LuisMiguelCarmonaCortes/IMPASS/Documentacion/Diagrama_IMPASS.png

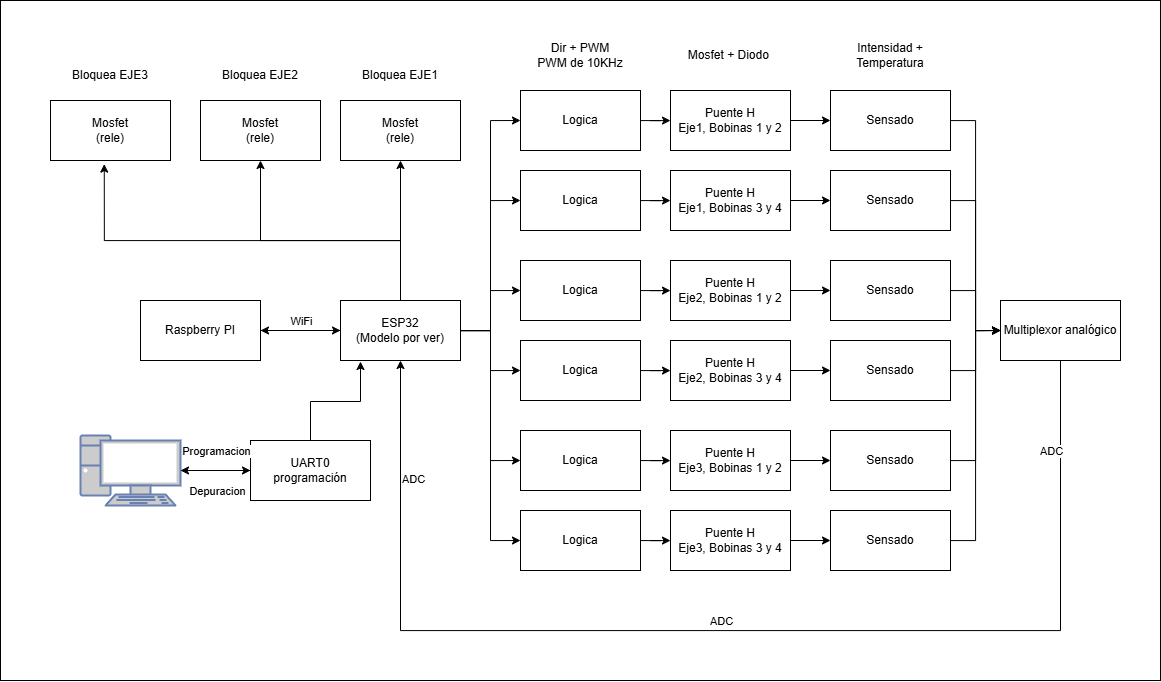
Documentacion/Diagrama_IMPASS.png
