LuisMiguelCarmonaCortes/IMPASS/Documentacion/Carro_ene.08_0310.xls

CESTA DE LA COMPRA
Esto no es una factura
08-ene.-26 15:10:57
 | Mouser REF | Fabr. N.º | Fabricante | Ref. Cliente | Descripción | RoHS | Ciclo de vida | Ctd. pedido | Precio (EUR) | Precio total: (EUR)
1 | 637-2N7002 | 2N7002 | Diotec Semiconductor |  | MOSFET MOSFET, SOT-23, 60V, 0.28A, 150C, N | Cumple RoHS |  | 50 | 0,077 € | 3,85 €
2 | 621-DMN3008SFG-7 | DMN3008SFG-7 | Diodes Incorporated |  | MOSFET 30V N-Ch Enh FET 4.6mOhm 10Vgs 17.6A | Cumple RoHS |  | 60 | 0,531 € | 31,86 €
3 | 581-06036C104KAT2A | 06036C104KAT2A | KYOCERA AVX |  | Condensadores de cerámica multicapa (MLCC- SMD/SMT) KGM15AR70J104KT NEW GLOBAL PN 6.3V 0.1uF A 581-KGM15AR70J104KT | Cumple RoHS |  | 20 | 0,025 € | 0,50 €
4 | 187-CL21A106KOQNNNG | CL21A106KOQNNNG | Samsung Electro-Mechanics |  | Condensadores de cerámica multicapa (MLCC- SMD/SMT) 10uF+/-10% 16V X5R 2 0805 | Cumple RoHS |  | 10 | 0,009 € | 0,09 €
5 | 581-KGM15AR71H102MT | KGM15AR71H102MT | KYOCERA AVX |  | Condensadores de cerámica multicapa (MLCC- SMD/SMT) 50V .001uF X7R 0603 20% | Cumple RoHS |  | 20 | 0,023 € | 0,46 €
6 | 708-RNCS0603BKE10K0 | RNCS0603BKE10K0 | SEI Stackpole |  | Resistores de pel&iacute;cula fina - SMD 10KOhms 0603 0.063W 25ppm 0.1% Moist Resist AEC-Q200 | Cumple RoHS |  | 60 | 0,082 € | 4,92 €
7 | 78-1N4448 | 1N4448TR | Vishay |  | Diodos de conmutación de señal pequeña Vr/75V Io/150mA T/R | Conforme con RoHS por exención |  | 15 | 0,027 € | 0,41 €
8 | 771-LM75BD118 | LM75BD,118 | NXP |  | Sensores de temperatura montados en placa I2C LOCAL +/- 20C TS DIGITAL TEMP SENSOR | Cumple RoHS |  | 5 | 0,442 € | 2,21 €
9 | 250-71240LLCBTR045B5 | ACS71240LLCBTR-045B5 | Allegro MicroSystems |  | Sensores de corriente montados en placa CURRENT SENSOR IC WITH COMMON MODE REJECTION | Conforme con RoHS por exención |  | 15 | 1,51 € | 22,65 €
10 | 356-ESP32S3WRM1N16R2 | ESP32-S3-WROOM-1-N16R2 | Espressif |  | Módulos multiprotocolo SMD module, ESP32-S3R2 with 2 MB PSRAM die inside, 16 MB SPI flash, PCB antenna | Cumple RoHS |  | 2 | 5,36 € | 10,72 €
11 | 179-TB0011-350-02GR | TB0011-350-02GR | Same Sky |  | Bloques terminales fijos 2 Poles, Screw Type, Horizontal, 3.50 Pitch, 24-18 (AWG), Green, Terminal Block Connector | Cumple RoHS | Nuevo producto | 20 | 0,347 € | 6,94 €
Al enviar su pedido, usted acepta estos términos y condiciones. (https://www.mouser.es/saleterms) |  |  |  |  |  |  |  |  | Mercancía: | 84,61 €
Los precios se reflejan en la fecha y hora mostradas. |  |  |  |  |  |  |  |  | Gastos de envío: | 0,00 €
