LuisMiguelCarmonaCortes/IMPASS/Hardware/PCB/IMPASS/IMPASS.kicad_pcb

## KiCad design Hardware/PCB/IMPASS/IMPASS.kicad_pcb (2026-03-23)

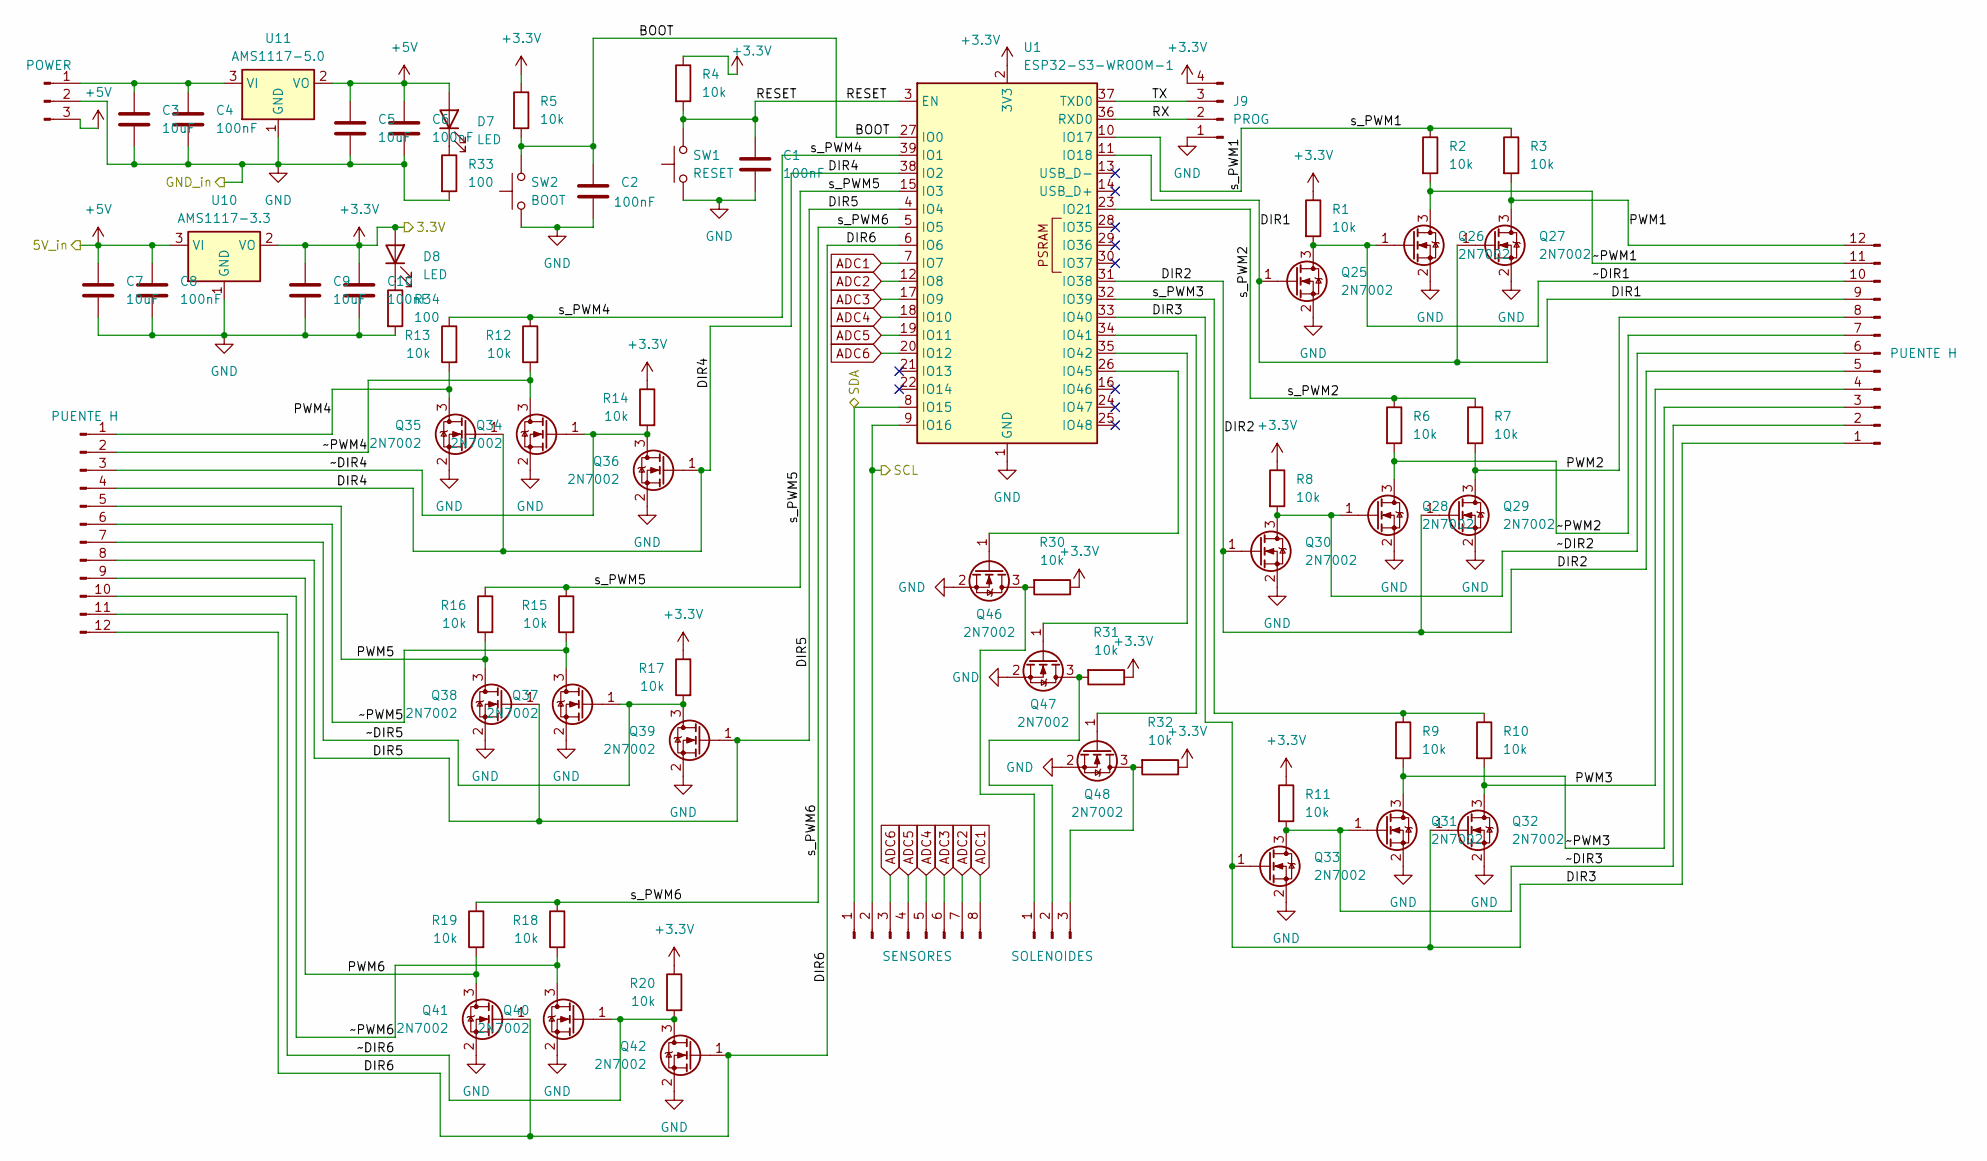
[picture p60: schematic Logica.kicad_sch]

Parts:
C1, C2, C4, C6, C8, C10: 100nF; C_0603_1608Metric
C3, C5, C7, C9: 10uF; C_0805_2012Metric
D7, D8: LED; LED_0603_1608Metric
J1, J7: PUENTE H; PinHeader_1x12_P2.54mm_Vertical
J8: SOLENOIDES; PinHeader_1x03_P2.54mm_Vertical
J9: PROG; PinHeader_1x04_P2.54mm_Horizontal
J10: SENSORES; PinHeader_1x08_P2.54mm_Vertical
J12: POWER; PinHeader_1x03_P2.54mm_Vertical
Q25, Q26, Q27, Q28, Q29, Q30, Q31, Q32, Q33, Q34, Q35, Q36, Q37, Q38, Q39, Q40, Q41, Q42, Q46, Q47, Q48: 2N7002; SOT-23
R1, R2, R3, R4, R5, R6, R7, R8, R9, R10, R11, R12, R13, R14, R15, R16, R17, R18, R19, R20, R30, R31, R32: 10k; R_0603_1608Metric
R33, R34: 100; R_0603_1608Metric
SW1: RESET; SW_PUSH_6mm_H5mm
SW2: BOOT; SW_PUSH_6mm_H5mm
U1: ESP32-S3-WROOM-1
U10: AMS1117-3.3; SOT-223-3_TabPin2
U11: AMS1117-5.0; SOT-223-3_TabPin2

Connections:
+3.3V: C9.1, C10.1, D8.2 (A), J9.4, R1.1, R4.1, R5.1, R8.1, R11.1, R14.1, R17.1, R20.1, R30.1, R31.1, R32.1, U1.2 (3V3), U10.2 (VO); also elsewhere on the board
+5V: C5.1, C6.1, C7.1, C8.1, D7.2 (A), J12.3, U10.3 (VI), U11.2 (VO)
/Logica/BOOT: C2.1, R5.2, SW2.2, U1.27 (IO0)
/Logica/DIR1: J7.9, Q25.1 (G), Q27.1 (G), U1.11 (IO18)
/Logica/DIR2: J7.5, Q29.1 (G), Q30.1 (G), U1.31 (IO38)
/Logica/DIR3: J7.1, Q32.1 (G), Q33.1 (G), U1.33 (IO40)
/Logica/DIR4: J1.4, Q35.1 (G), Q36.1 (G), U1.38 (IO2)
/Logica/DIR5: J1.8, Q38.1 (G), Q39.1 (G), U1.4 (IO4)
/Logica/DIR6: J1.12, Q41.1 (G), Q42.1 (G), U1.6 (IO6)
/Logica/PWM1: J7.12, Q27.3 (D), R3.2
/Logica/PWM2: J7.8, Q29.3 (D), R7.2
/Logica/PWM3: J7.4, Q32.3 (D), R10.2
/Logica/PWM4: J1.1, Q35.3 (D), R13.2
/Logica/PWM5: J1.5, Q38.3 (D), R16.2
/Logica/PWM6: J1.9, Q41.3 (D), R19.2
/Logica/RESET: C1.1, R4.2, SW1.2, U1.3 (EN)
/Logica/RX: J9.2, U1.36 (RXD0)
/Logica/SCL: J10.2, U1.9 (IO16); also elsewhere on the board
/Logica/SDA: J10.1, U1.8 (IO15); also elsewhere on the board
/Logica/TX: J9.3, U1.37 (TXD0)
/Logica/s_PWM1: R2.1, R3.1, U1.10 (IO17)
/Logica/s_PWM2: R6.1, R7.1, U1.23 (IO21)
/Logica/s_PWM3: R9.1, R10.1, U1.32 (IO39)
/Logica/s_PWM4: R12.1, R13.1, U1.39 (IO1)
/Logica/s_PWM5: R15.1, R16.1, U1.15 (IO3)
/Logica/s_PWM6: R18.1, R19.1, U1.5 (IO5)
/Logica/~DIR1: J7.10, Q25.3 (D), Q26.1 (G), R1.2
/Logica/~DIR2: J7.6, Q28.1 (G), Q30.3 (D), R8.2
/Logica/~DIR3: J7.2, Q31.1 (G), Q33.3 (D), R11.2
/Logica/~DIR4: J1.3, Q34.1 (G), Q36.3 (D), R14.2
/Logica/~DIR5: J1.7, Q37.1 (G), Q39.3 (D), R17.2
/Logica/~DIR6: J1.11, Q40.1 (G), Q42.3 (D), R20.2
/Logica/~PWM1: J7.11, Q26.3 (D), R2.2
/Logica/~PWM2: J7.7, Q28.3 (D), R6.2
/Logica/~PWM3: J7.3, Q31.3 (D), R9.2
/Logica/~PWM4: J1.2, Q34.3 (D), R12.2
/Logica/~PWM5: J1.6, Q37.3 (D), R15.2
/Logica/~PWM6: J1.10, Q40.3 (D), R18.2
ADC1: J10.8, U1.7 (IO7)
ADC2: J10.7, U1.12 (IO8)
ADC3: J10.6, U1.17 (IO9)
ADC4: J10.5, U1.18 (IO10)
ADC5: J10.4, U1.19 (IO11)
ADC6: J10.3, U1.20 (IO12)
GND: C1.2, C2.2, C3.2, C4.2, C5.2, C6.2, C7.2, C8.2, C9.2, C10.2, J9.1, J12.2, Q25.2 (S), Q26.2 (S), Q27.2 (S), Q28.2 (S), Q29.2 (S), Q30.2 (S), Q31.2 (S), Q32.2 (S), Q33.2 (S), Q34.2 (S), Q35.2 (S), Q36.2 (S), Q37.2 (S), Q38.2 (S), Q39.2 (S), Q40.2 (S), Q41.2 (S), Q42.2 (S), Q46.2 (S), Q47.2 (S), Q48.2 (S), R33.2, R34.2, SW1.1, SW2.1, U1.1 (GND), U1.40 (GND), U1.41 (GND), U10.1 (GND), U11.1 (GND); also elsewhere on the board
unnamed: D7.1 (K), R33.1
unnamed: D8.1 (K), R34.1
unnamed: J8.1, Q46.3 (D), R30.2
unnamed: J8.2, Q47.3 (D), R31.2
unnamed: J8.3, Q48.3 (D), R32.2
unnamed: C3.1, C4.1, J12.1, U11.3 (VI)
unnamed: Q46.1 (G), U1.26 (IO45)
unnamed: Q47.1 (G), U1.35 (IO42)
unnamed: Q48.1 (G), U1.34 (IO41)

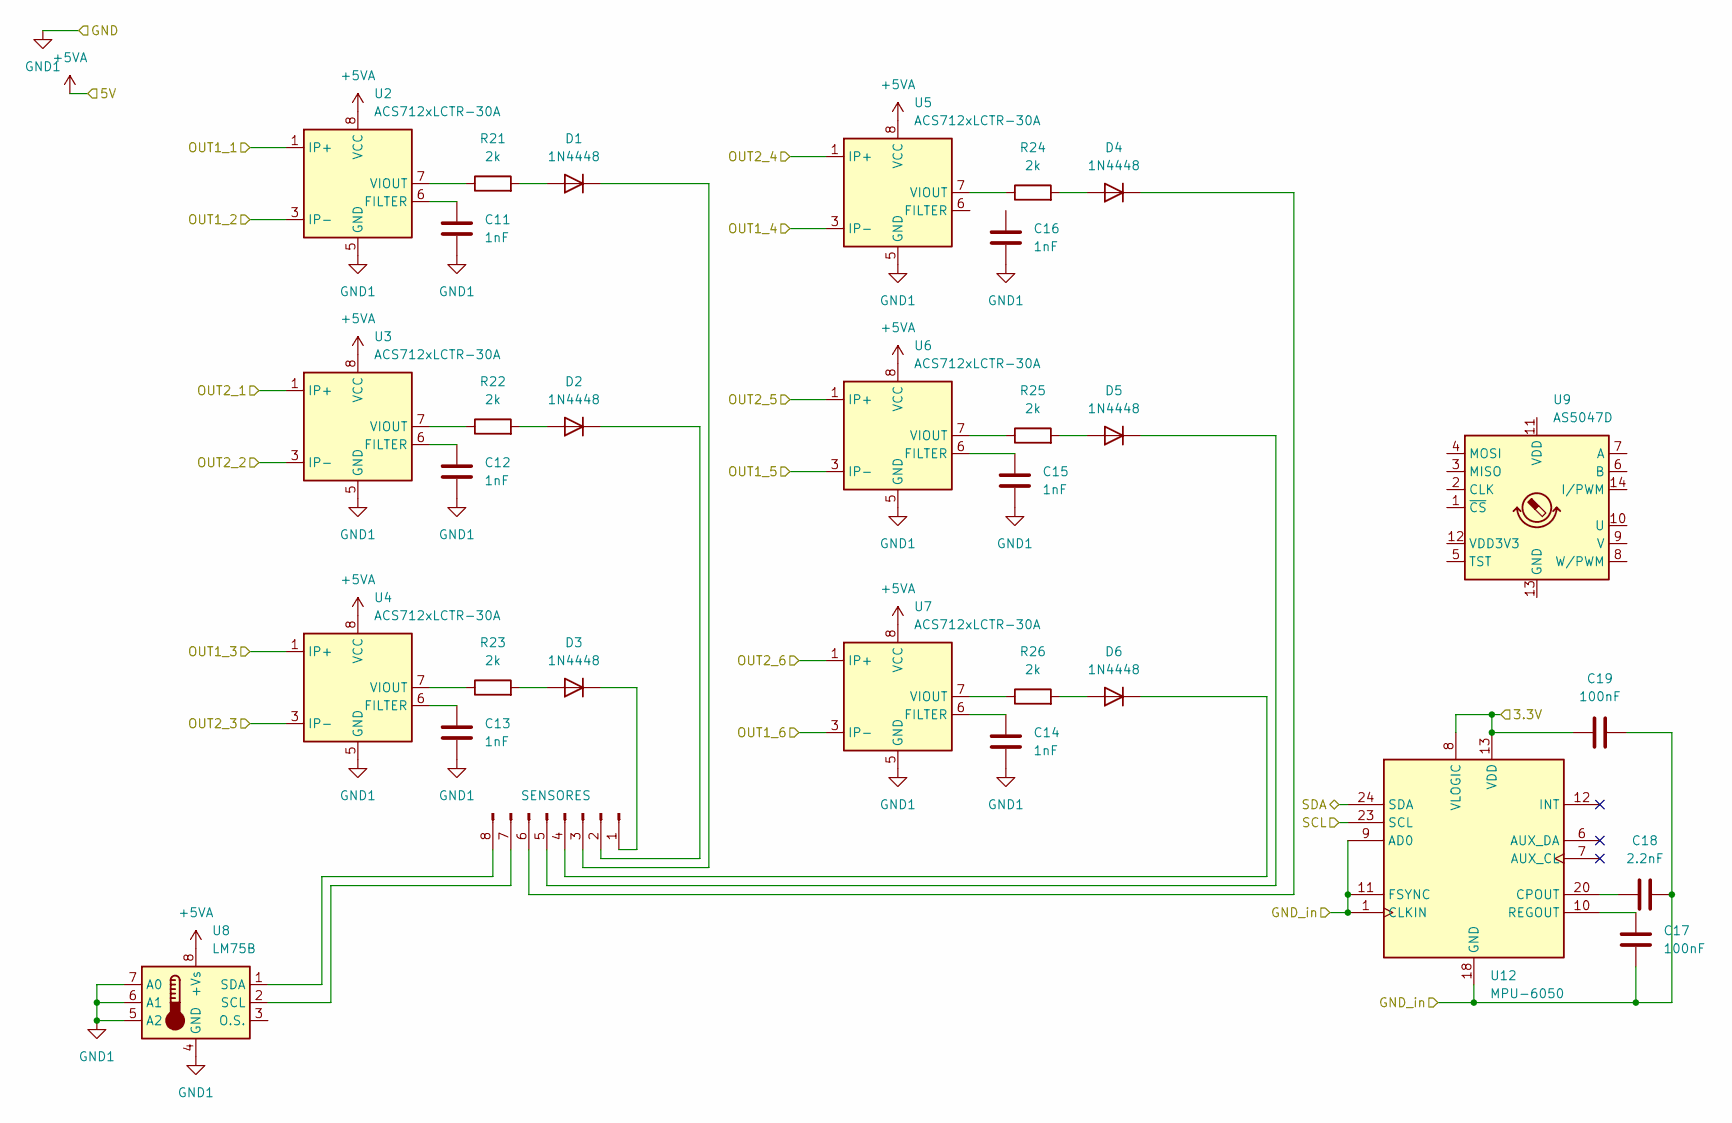
[picture p61: schematic sensorres.kicad_sch]

Parts:
C11, C12, C13, C14, C15, C16: 1nF; C_0603_1608Metric
C17, C19: 100nF; C_0603_1608Metric
C18: 2.2nF; C_0603_1608Metric
D1, D2, D3, D4, D5, D6: 1N4448; D_DO-35_SOD27_P2.54mm_Vertical_AnodeUp
J13: SENSORES; PinHeader_1x08_P2.54mm_Vertical
R21, R22, R23, R24, R25, R26: 2k; R_0603_1608Metric
U2, U3, U4, U5, U6, U7: ACS712xLCTR-30A; SOIC-8_3.9x4.9mm_P1.27mm
U8: LM75B; SOIC-8_3.9x4.9mm_P1.27mm
U9: AS5047D; TSSOP-14_4.4x5mm_P0.65mm
U12: MPU-6050; InvenSense_QFN-24_4x4mm_P0.5mm

Connections:
+3.3V: C19.1, U12.8 (VLOGIC), U12.13 (VDD); also elsewhere on the board
+5VA: U2.8 (VCC), U3.8 (VCC), U4.8 (VCC), U5.8 (VCC), U6.8 (VCC), U7.8 (VCC), U8.8 (+Vs); also elsewhere on the board
/Logica/SCL: U12.23 (SCL); also elsewhere on the board
/Logica/SDA: U12.24 (SDA); also elsewhere on the board
GND: C17.2, C18.2, C19.2, U12.1 (CLKIN), U12.9 (AD0), U12.11 (FSYNC), U12.18 (GND); also elsewhere on the board
GND1: C11.2, C12.2, C13.2, C14.2, C15.2, C16.2, U2.5 (GND), U3.5 (GND), U4.5 (GND), U5.5 (GND), U6.5 (GND), U7.5 (GND), U8.4 (GND), U8.5 (A2), U8.6 (A1), U8.7 (A0); also elsewhere on the board
unnamed: D1.2 (A), R21.2
unnamed: D1.1 (K), J13.3
unnamed: D2.2 (A), R22.2
unnamed: D2.1 (K), J13.2
unnamed: D3.2 (A), R23.2
unnamed: D3.1 (K), J13.1
unnamed: D4.2 (A), R24.2
unnamed: D4.1 (K), J13.6
unnamed: D5.2 (A), R25.2
unnamed: D5.1 (K), J13.5
unnamed: D6.2 (A), R26.2
unnamed: D6.1 (K), J13.4
unnamed: J13.7, U8.2 (SCL)
unnamed: J13.8, U8.1 (SDA)
unnamed: C11.1, U2.6 (FILTER)
unnamed: R21.1, U2.7 (VIOUT)
unnamed: C12.1, U3.6 (FILTER)
unnamed: R22.1, U3.7 (VIOUT)
unnamed: C13.1, U4.6 (FILTER)
unnamed: R23.1, U4.7 (VIOUT)
unnamed: R24.1, U5.7 (VIOUT)
unnamed: C15.1, U6.6 (FILTER)
unnamed: R25.1, U6.7 (VIOUT)
unnamed: C14.1, U7.6 (FILTER)
unnamed: R26.1, U7.7 (VIOUT)
unnamed: C18.1, U12.20 (CPOUT)
unnamed: C17.1, U12.10 (REGOUT)
out1_1: U2.1 (IP+), U2.2 (IP+); also elsewhere on the board
out1_2: U2.3 (IP-), U2.4 (IP-); also elsewhere on the board
out1_3: U4.1 (IP+), U4.2 (IP+); also elsewhere on the board
out1_4: U4.3 (IP-), U4.4 (IP-); also elsewhere on the board
out1_5: U6.3 (IP-), U6.4 (IP-); also elsewhere on the board
out1_6: U7.3 (IP-), U7.4 (IP-); also elsewhere on the board
out2_1: U3.1 (IP+), U3.2 (IP+); also elsewhere on the board
out2_2: U3.3 (IP-), U3.4 (IP-); also elsewhere on the board
out2_3: U5.3 (IP-), U5.4 (IP-); also elsewhere on the board
out2_4: U5.1 (IP+), U5.2 (IP+); also elsewhere on the board
out2_5: U6.1 (IP+), U6.2 (IP+); also elsewhere on the board
out2_6: U7.1 (IP+), U7.2 (IP+); also elsewhere on the board

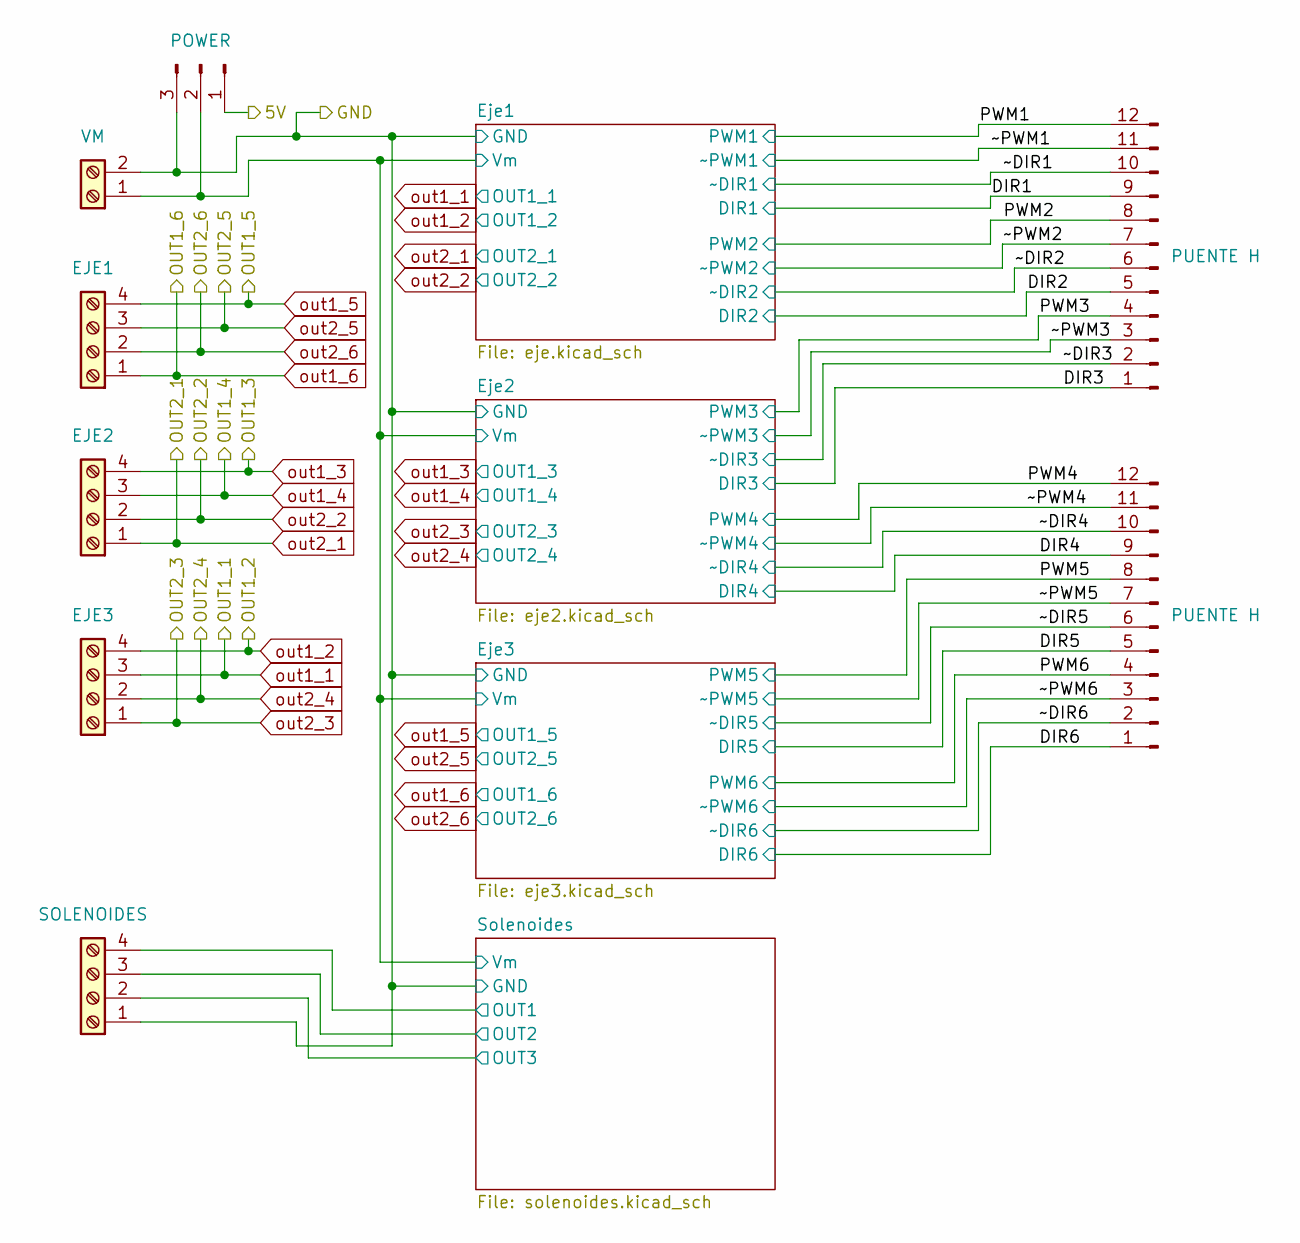
[picture p62: schematic Potencia.kicad_sch]

Parts:
J2: POWER; PinHeader_1x03_P2.54mm_Vertical
J3: EJE1; TerminalBlock_Phoenix_PT-1,5-4-3.5-H_1x04_P3.50mm_Horizontal
J4: EJE2; TerminalBlock_Phoenix_PT-1,5-4-3.5-H_1x04_P3.50mm_Horizontal
J5: EJE3; TerminalBlock_Phoenix_PT-1,5-4-3.5-H_1x04_P3.50mm_Horizontal
J6: VM; TerminalBlock_Phoenix_PT-1,5-2-3.5-H_1x02_P3.50mm_Horizontal
J14: SOLENOIDES; TerminalBlock_Phoenix_PT-1,5-4-3.5-H_1x04_P3.50mm_Horizontal
J15, J16: PUENTE H; PinHeader_1x12_P2.54mm_Vertical

Connections:
+5VA: J2.1; also elsewhere on the board
/Potencia/DIR1: J15.9; also elsewhere on the board
/Potencia/DIR2: J15.5; also elsewhere on the board
/Potencia/DIR3: J15.1; also elsewhere on the board
/Potencia/DIR4: J16.9; also elsewhere on the board
/Potencia/DIR5: J16.5; also elsewhere on the board
/Potencia/DIR6: J16.1; also elsewhere on the board
/Potencia/Eje1/Vm: J2.2, J6.1; also elsewhere on the board
/Potencia/PWM1: J15.12; also elsewhere on the board
/Potencia/PWM2: J15.8; also elsewhere on the board
/Potencia/PWM3: J15.4; also elsewhere on the board
/Potencia/PWM4: J16.12; also elsewhere on the board
/Potencia/PWM5: J16.8; also elsewhere on the board
/Potencia/PWM6: J16.4; also elsewhere on the board
/Potencia/Solenoides/OUT1: J14.4; also elsewhere on the board
/Potencia/Solenoides/OUT2: J14.3; also elsewhere on the board
/Potencia/Solenoides/OUT3: J14.2; also elsewhere on the board
/Potencia/~DIR1: J15.10; also elsewhere on the board
/Potencia/~DIR2: J15.6; also elsewhere on the board
/Potencia/~DIR3: J15.2; also elsewhere on the board
/Potencia/~DIR4: J16.10; also elsewhere on the board
/Potencia/~DIR5: J16.6; also elsewhere on the board
/Potencia/~DIR6: J16.2; also elsewhere on the board
/Potencia/~PWM1: J15.11; also elsewhere on the board
/Potencia/~PWM2: J15.7; also elsewhere on the board
/Potencia/~PWM3: J15.3; also elsewhere on the board
/Potencia/~PWM4: J16.11; also elsewhere on the board
/Potencia/~PWM5: J16.7; also elsewhere on the board
/Potencia/~PWM6: J16.3; also elsewhere on the board
GND1: J2.3, J6.2, J14.1; also elsewhere on the board
out1_1: J5.3; also elsewhere on the board
out1_2: J5.4; also elsewhere on the board
out1_3: J4.4; also elsewhere on the board
out1_4: J4.3; also elsewhere on the board
out1_5: J3.4; also elsewhere on the board
out1_6: J3.1; also elsewhere on the board
out2_1: J4.1; also elsewhere on the board
out2_2: J4.2; also elsewhere on the board
out2_3: J5.1; also elsewhere on the board
out2_4: J5.2; also elsewhere on the board
out2_5: J3.3; also elsewhere on the board
out2_6: J3.2; also elsewhere on the board

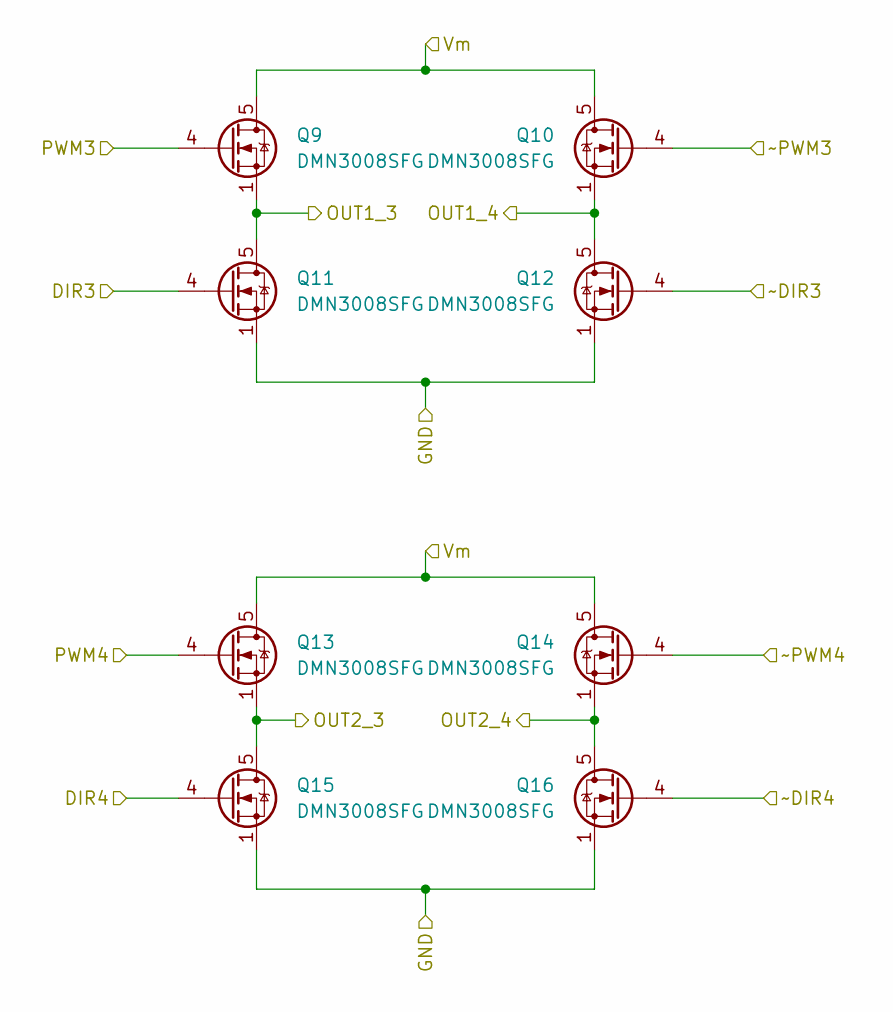
[picture p63: schematic eje2.kicad_sch]

Parts:
Q9, Q10, Q11, Q12, Q13, Q14, Q15, Q16: DMN3008SFG; Diodes_PowerDI3333-8

Connections:
/Potencia/DIR3: Q11.4 (G); also elsewhere on the board
/Potencia/DIR4: Q15.4 (G); also elsewhere on the board
/Potencia/Eje1/Vm: Q9.5 (D), Q10.5 (D), Q13.5 (D), Q14.5 (D); also elsewhere on the board
/Potencia/PWM3: Q9.4 (G); also elsewhere on the board
/Potencia/PWM4: Q13.4 (G); also elsewhere on the board
/Potencia/~DIR3: Q12.4 (G); also elsewhere on the board
/Potencia/~DIR4: Q16.4 (G); also elsewhere on the board
/Potencia/~PWM3: Q10.4 (G); also elsewhere on the board
/Potencia/~PWM4: Q14.4 (G); also elsewhere on the board
GND1: Q11.1 (S), Q11.2 (S), Q11.3 (S), Q12.1 (S), Q12.2 (S), Q12.3 (S), Q15.1 (S), Q15.2 (S), Q15.3 (S), Q16.1 (S), Q16.2 (S), Q16.3 (S); also elsewhere on the board
out1_3: Q9.1 (S), Q9.2 (S), Q9.3 (S), Q11.5 (D); also elsewhere on the board
out1_4: Q10.1 (S), Q10.2 (S), Q10.3 (S), Q12.5 (D); also elsewhere on the board
out2_3: Q13.1 (S), Q13.2 (S), Q13.3 (S), Q15.5 (D); also elsewhere on the board
out2_4: Q14.1 (S), Q14.2 (S), Q14.3 (S), Q16.5 (D); also elsewhere on the board

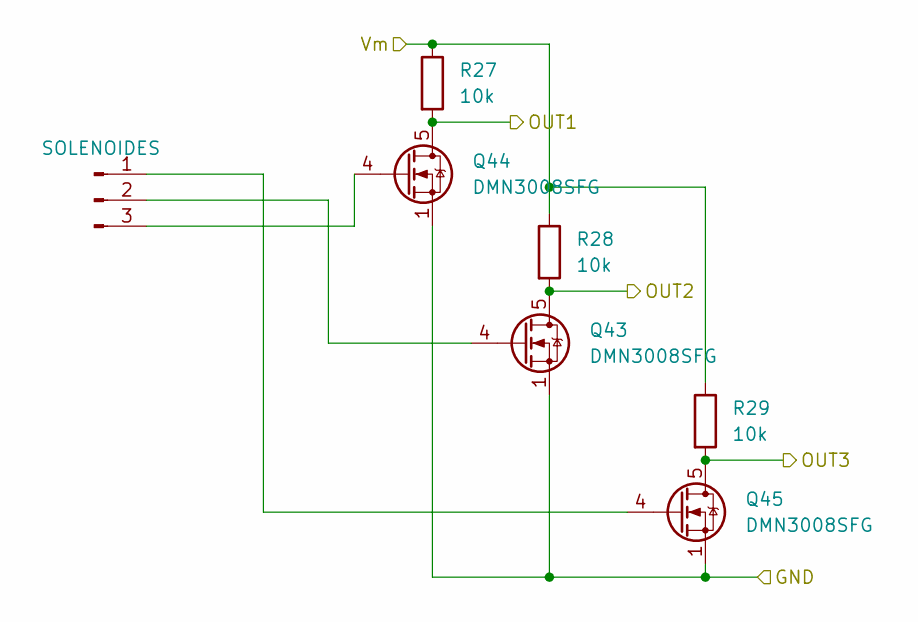
[picture p64: schematic solenoides.kicad_sch]

Parts:
J11: SOLENOIDES; PinHeader_1x03_P2.54mm_Vertical
Q43, Q44, Q45: DMN3008SFG; Diodes_PowerDI3333-8
R27, R28, R29: 10k; R_0603_1608Metric

Connections:
/Potencia/Eje1/Vm: R27.1, R28.1, R29.1; also elsewhere on the board
/Potencia/Solenoides/OUT1: Q44.5 (D), R27.2; also elsewhere on the board
/Potencia/Solenoides/OUT2: Q43.5 (D), R28.2; also elsewhere on the board
/Potencia/Solenoides/OUT3: Q45.5 (D), R29.2; also elsewhere on the board
GND1: Q43.1 (S), Q43.2 (S), Q43.3 (S), Q44.1 (S), Q44.2 (S), Q44.3 (S), Q45.1 (S), Q45.2 (S), Q45.3 (S); also elsewhere on the board
unnamed: J11.1, Q45.4 (G)
unnamed: J11.2, Q43.4 (G)
unnamed: J11.3, Q44.4 (G)

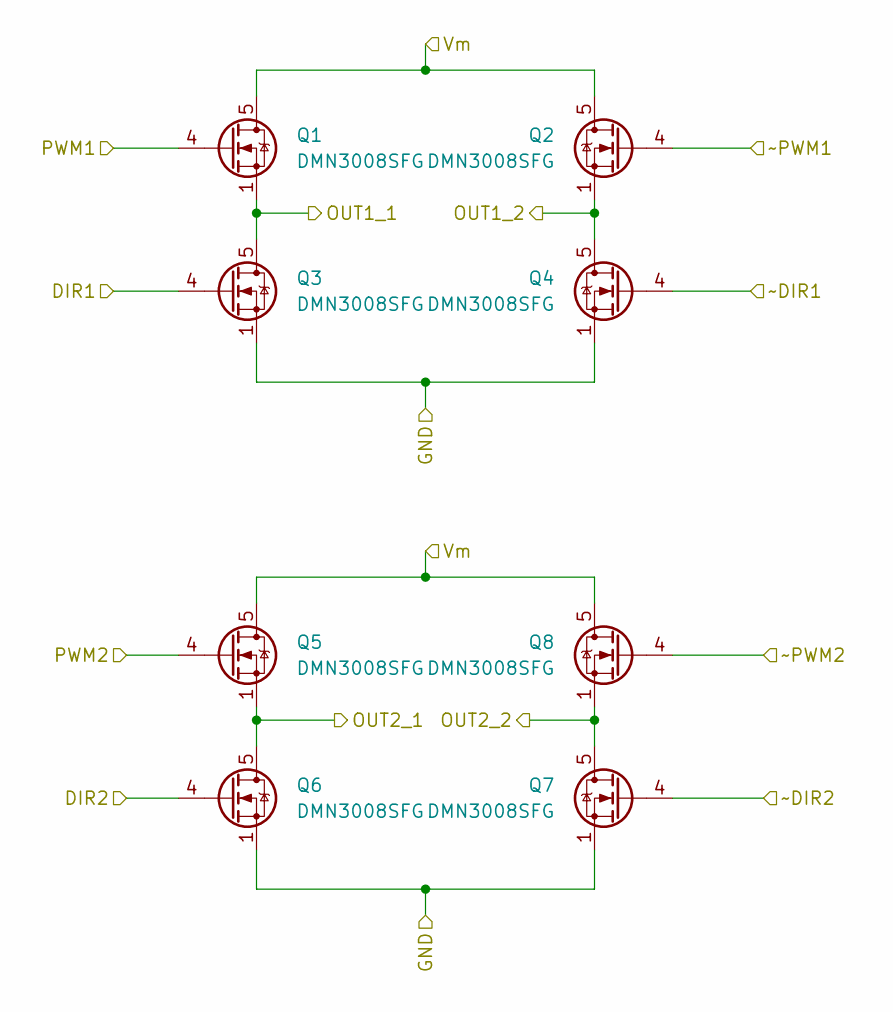
[picture p65: schematic eje.kicad_sch]

Parts:
Q1, Q2, Q3, Q4, Q5, Q6, Q7, Q8: DMN3008SFG; Diodes_PowerDI3333-8

Connections:
/Potencia/DIR1: Q3.4 (G); also elsewhere on the board
/Potencia/DIR2: Q6.4 (G); also elsewhere on the board
/Potencia/Eje1/Vm: Q1.5 (D), Q2.5 (D), Q5.5 (D), Q8.5 (D); also elsewhere on the board
/Potencia/PWM1: Q1.4 (G); also elsewhere on the board
/Potencia/PWM2: Q5.4 (G); also elsewhere on the board
/Potencia/~DIR1: Q4.4 (G); also elsewhere on the board
/Potencia/~DIR2: Q7.4 (G); also elsewhere on the board
/Potencia/~PWM1: Q2.4 (G); also elsewhere on the board
/Potencia/~PWM2: Q8.4 (G); also elsewhere on the board
GND1: Q3.1 (S), Q3.2 (S), Q3.3 (S), Q4.1 (S), Q4.2 (S), Q4.3 (S), Q6.1 (S), Q6.2 (S), Q6.3 (S), Q7.1 (S), Q7.2 (S), Q7.3 (S); also elsewhere on the board
out1_1: Q1.1 (S), Q1.2 (S), Q1.3 (S), Q3.5 (D); also elsewhere on the board
out1_2: Q2.1 (S), Q2.2 (S), Q2.3 (S), Q4.5 (D); also elsewhere on the board
out2_1: Q5.1 (S), Q5.2 (S), Q5.3 (S), Q6.5 (D); also elsewhere on the board
out2_2: Q7.5 (D), Q8.1 (S), Q8.2 (S), Q8.3 (S); also elsewhere on the board

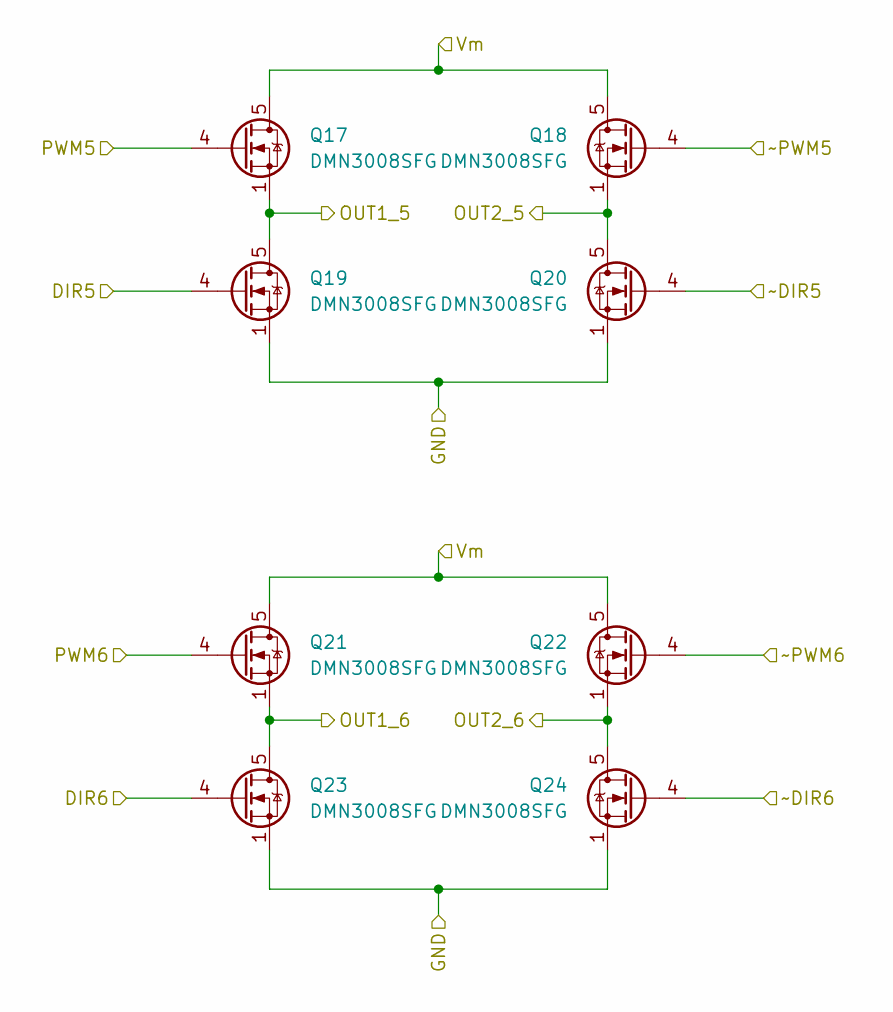
[picture p66: schematic eje3.kicad_sch]

Parts:
Q17, Q18, Q19, Q20, Q21, Q22, Q23, Q24: DMN3008SFG; Diodes_PowerDI3333-8

Connections:
/Potencia/DIR5: Q19.4 (G); also elsewhere on the board
/Potencia/DIR6: Q23.4 (G); also elsewhere on the board
/Potencia/Eje1/Vm: Q17.5 (D), Q18.5 (D), Q21.5 (D), Q22.5 (D); also elsewhere on the board
/Potencia/PWM5: Q17.4 (G); also elsewhere on the board
/Potencia/PWM6: Q21.4 (G); also elsewhere on the board
/Potencia/~DIR5: Q20.4 (G); also elsewhere on the board
/Potencia/~DIR6: Q24.4 (G); also elsewhere on the board
/Potencia/~PWM5: Q18.4 (G); also elsewhere on the board
/Potencia/~PWM6: Q22.4 (G); also elsewhere on the board
GND1: Q19.1 (S), Q19.2 (S), Q19.3 (S), Q20.1 (S), Q20.2 (S), Q20.3 (S), Q23.1 (S), Q23.2 (S), Q23.3 (S), Q24.1 (S), Q24.2 (S), Q24.3 (S); also elsewhere on the board
out1_5: Q17.1 (S), Q17.2 (S), Q17.3 (S), Q19.5 (D); also elsewhere on the board
out1_6: Q21.1 (S), Q21.2 (S), Q21.3 (S), Q23.5 (D); also elsewhere on the board
out2_5: Q18.1 (S), Q18.2 (S), Q18.3 (S), Q20.5 (D); also elsewhere on the board
out2_6: Q22.1 (S), Q22.2 (S), Q22.3 (S), Q24.5 (D); also elsewhere on the board

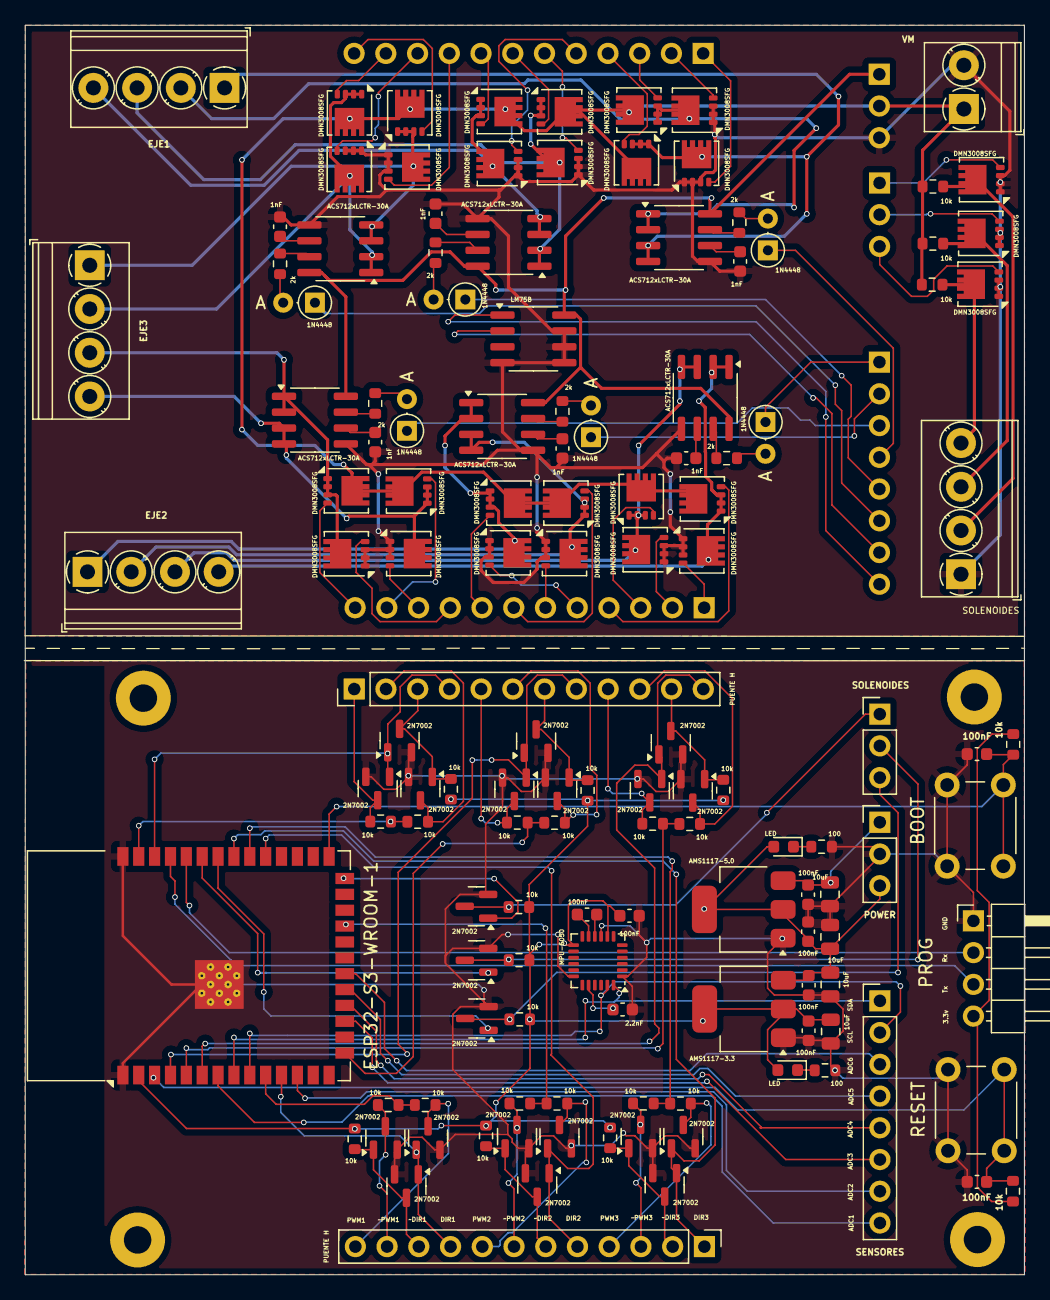
[picture p67: board IMPASS.kicad_pcb from above]

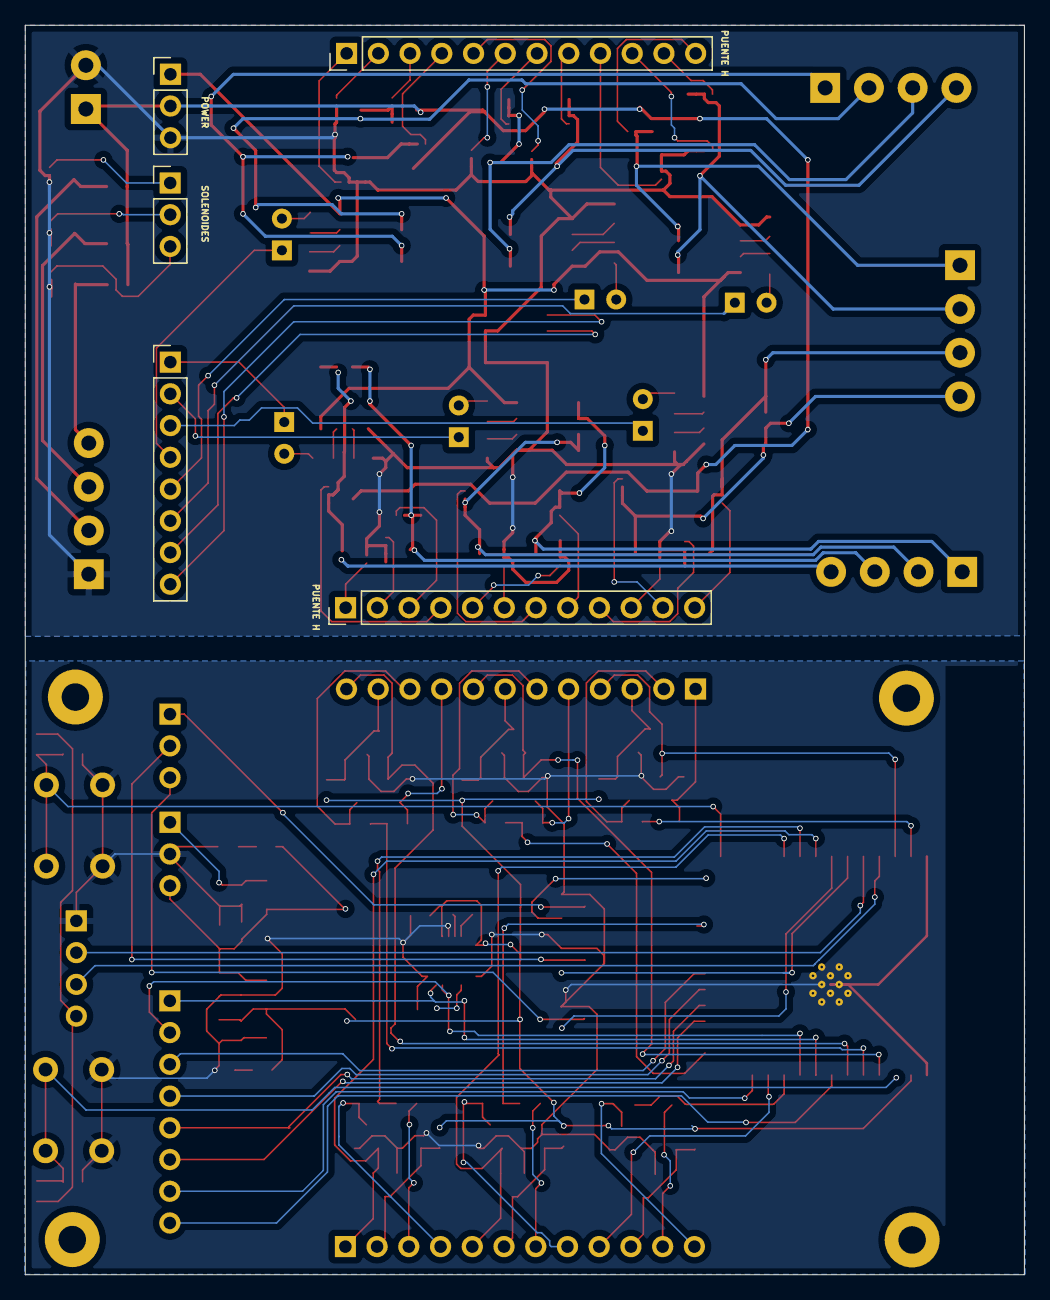
[picture p68: board IMPASS.kicad_pcb from below]

Board: 2 copper layers, 80.0 x 100.0 mm, 138 parts (5 on the bottom side), 126 nets.
