LuisMiguelCarmonaCortes/IMPASS/(commit log)

2026-03-23 Añadir IMPASS como carpeta normal
    [Carro_ene.08_0310.xls, IMPASS.kicad_pcb, IMPASS.kicad_sch, Logica.kicad_sch, Potencia.kicad_sch, eje.kicad_sch, eje2.kicad_sch, eje3.kicad_sch]
2026-03-23 Repositorio Restored
    [Carro_ene.08_0310.xls, IMPASS.kicad_pcb, IMPASS.kicad_sch, Logica.kicad_sch, Potencia.kicad_sch, eje.kicad_sch, eje2.kicad_sch, eje3.kicad_sch]
